Gbertaz/GloBoSaT/images/neo-m9n.jpg

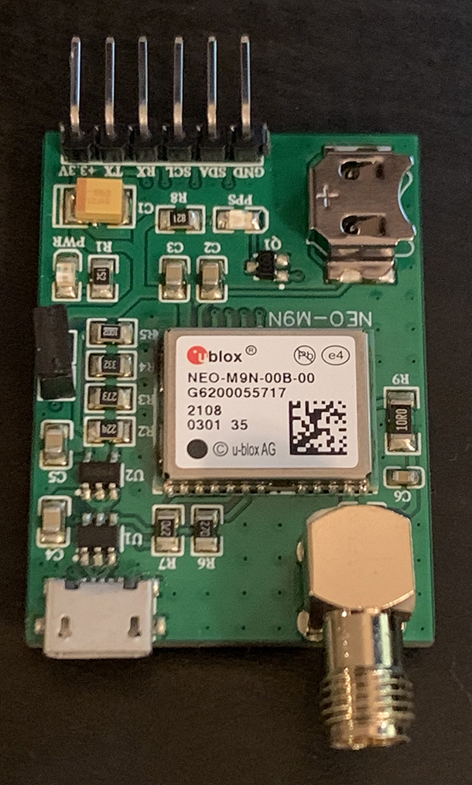
images/neo-m9n.jpg
