Gbertaz/GloBoSaT/Schematics/Schematic_Globosat_2021-02-20.pdf

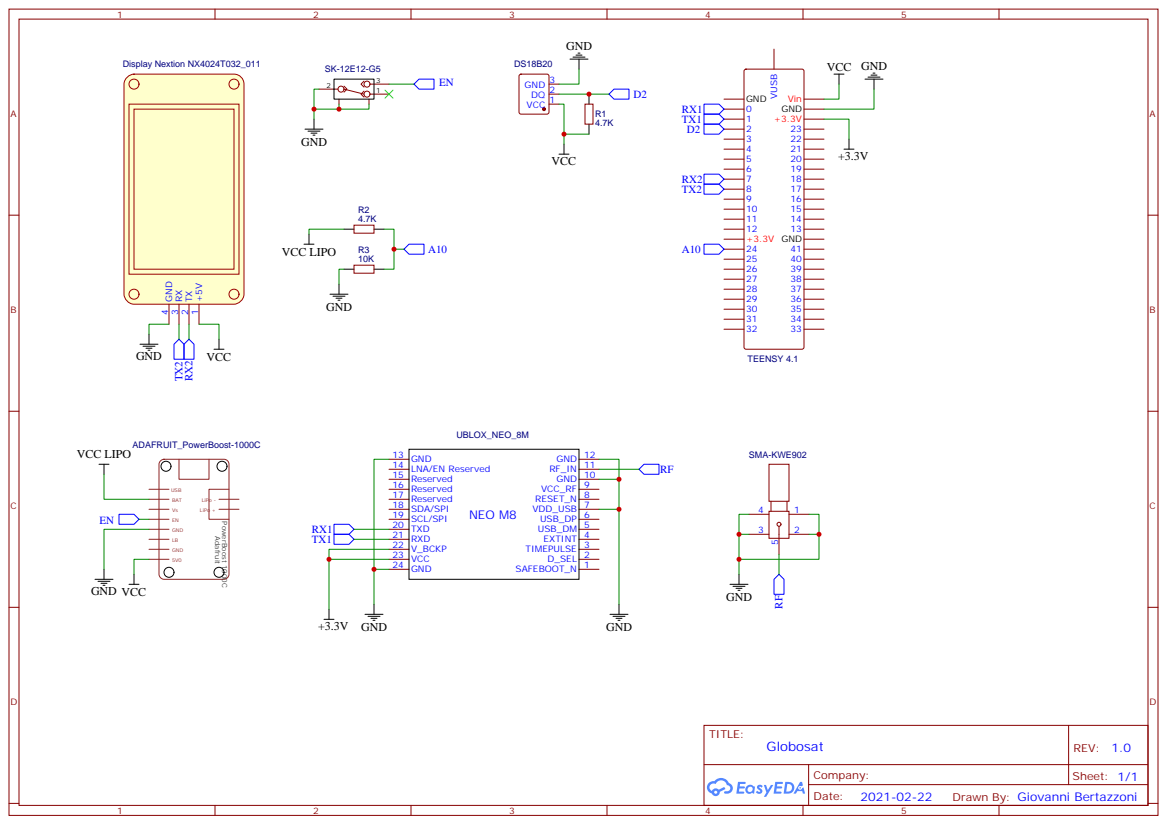
[picture p12: page 1]

Drawn By: Giovanni Bertazzoni
