Gbertaz/GloBoSaT/(commit log)

2021-04-23 Added source code and schematics
2021-04-26 Reset missed fix count when the gps update rate is selected
    [GloBoSaT.ino, NavigationData.h]
2021-05-19 Add test case
